Brownomobola/MEE_202_Project/Circuit_diagram.png

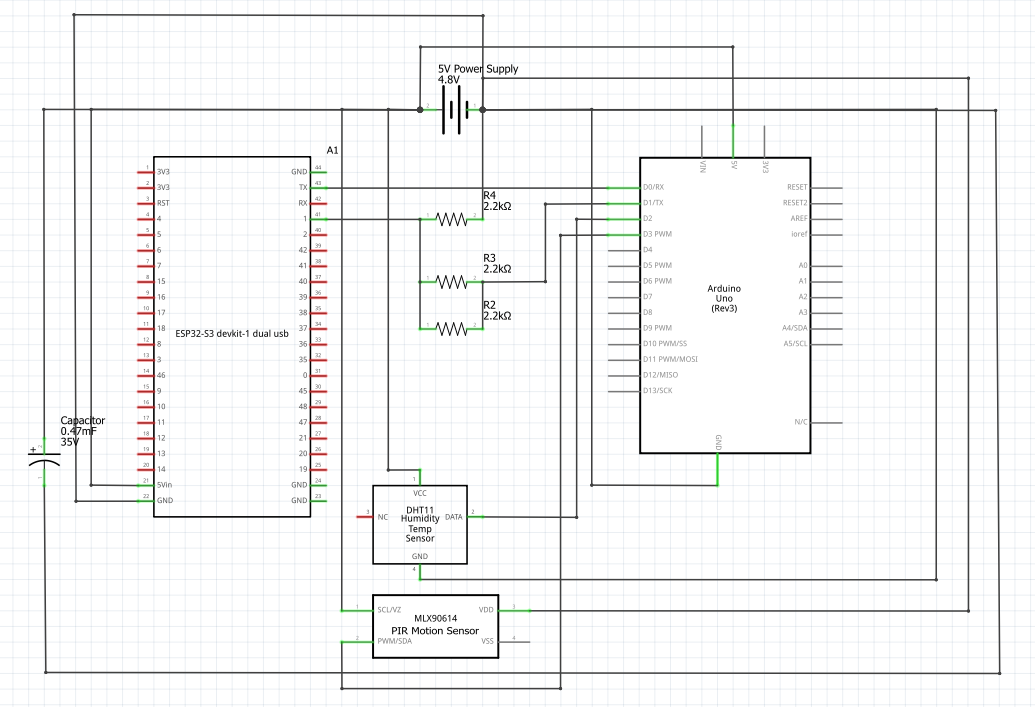
Circuit_diagram.png
