Brownomobola/MEE_202_Project/Arduino_code/arduino_code.ino

#include <DHT.h>

#define DHTTYPE DHT11

const int dhtPin = 2;
const int ledPin = 13;
const int pirPin = 3;
volatile bool motionDetected = false;

DHT dht(dhtPin, DHTTYPE);

unsigned long lastRead = 0;
const unsigned long interval = 2000;

// Non-blocking LED flash state -- no delay() here, so it can't interfere
// with PIR interrupt timing or slow down the main loop.
const unsigned long LED_FLASH_MS = 300;
volatile unsigned long lastTriggerTime = 0;
const unsigned long DEBOUNCE_MS = 3000;
unsigned long lastLedFlash = 0;

void flashLed() {
  digitalWrite(ledPin, HIGH);
  lastLedFlash = millis();
  if (lastLedFlash == 0) lastLedFlash == 1;
}

void setup() {
  digitalWrite(ledPin, HIGH);
  delay(1000);
  digitalWrite(ledPin, LOW);

  Serial.begin(9600);   // wired directly to ESP32 RX/TX (through a voltage divider)
                         // — disconnect this wire before uploading new sketches
  dht.begin();

  pinMode(pirPin, INPUT);
  pinMode(ledPin, OUTPUT);
  digitalWrite(ledPin, LOW);
  attachInterrupt(digitalPinToInterrupt(pirPin), pirISR, RISING);
}

void loop() {
  // Turn the LED back off once its flash window has elapsed. Checked every
  // loop iteration, but cheap -- just a comparison, no blocking.
  if (lastLedFlash != 0 && (millis() - lastLedFlash > LED_FLASH_MS)) {
    digitalWrite(ledPin, LOW);
    lastLedFlash = 0;
  }

  unsigned long now = millis();
  if (now - lastRead >= interval) {
    lastRead = now;
    float h = dht.readHumidity();
    float t = dht.readTemperature();
    if (!isnan(h) && !isnan(t)) {
      Serial.print("T:");
      Serial.print(t);
      Serial.print(",H:");
      Serial.println(h);
      flashLed();
    }
  }

  if (motionDetected) {
    Serial.println("M:1");  // matches parseLine handling on the ESP32 side
    flashLed();
    motionDetected = false;
  }
}

void pirISR() {
  unsigned long now = millis();
  if (now - lastTriggerTime > DEBOUNCE_MS) {
    motionDetected = true;
    lastTriggerTime = now;
  }
}
