Brownomobola/MEE_202_Project/(commit log)

2026-09-05 Fix CameraWebServer_New: remove nested git repo, track as normal folder
    [partitions.csv]
2026-09-10 feat: stabilize event-driven motion pipeline and add Telegram alerts
    This commit overhauls the motion detection pipeline to ensure seamless,
    non-blocking communication between the Arduino, ESP32, and Python scripts.
    ESP32 (C++):
    - Removed a blocking `delay(100)` in the green LED temperature indicator
    by implementing a `millis()`-based state machine, preventing dropped
    Serial messages from the Arduino.
    - Bridged the Arduino PIR trigger to the HTTP server by introducing a
    global `hardwareMotionDetected` flag with a 3-second auto-clear timer.
    - Updated the `/sensor` endpoint's JSON payload to include the `"motion"`
    key so the Python script can successfully poll for hardware events.
    Ar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
    [arduino_code.ino]
2026-09-10 feat: migrate to native USB serial streaming and VGA resolution
    This commit completely replaces the Wi-Fi/HTTP architecture with a
    high-speed, native USB-OTG serial connection, creating a hybrid
    event-driven and live-streaming security pipeline.
    This is done in the MEE202_CamOverSerial sketchbbok and the person_detect_3
    python script
    - Removed all Wi-Fi and web server dependencies.
    - Implemented a binary "Magic Bytes" protocol to multiplex JPEGs,
    PIR motion triggers, and DHT11 data over a single USB stream.
    - Upgraded camera resolution to VGA (640x480) and adjusted JPEG
    quality (15) to balance detail with USB bandwidth limits.
    - Configured native USB CDC to forward Arduino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
    [MEE202_CamOverSerial.ino, person_detect_3.py]
2026-09-11 fix: resolve JPEG decode failures on serial video stream
    Frames were streaming with valid JPEG SOI/EOI markers but failing
    cv2.imdecode() with 100% failure rate.
    Ruled out via isolation testing:
    - Raw byte transport (0x00-0xFF loopback test) - clean, no corruption
    - Python-side buffer parsing/framing logic - clean, correctly finds
    markers and decodes a static test JPEG 35+ times in a row
    - Protocol/magic byte design - unaffected
    Root cause: race between camera frame buffer (fb_count=2,
    CAMERA_GRAB_LATEST) and Serial.write() transmission time. Loop was
    fast enough that fb->buf could be overwritten by the driver's next
    capture while still being read out over serial, corrupting frame
    data m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
    [partitions.csv]
2026-09-11 Edited the README to reflect the project structure
    Included the project report and circuit diagram for future reference.
2026-10-21 Included a condition to print the error message from telegram
